tajwarTX/Team-X-FANATIC/t-photos/serious.jpg

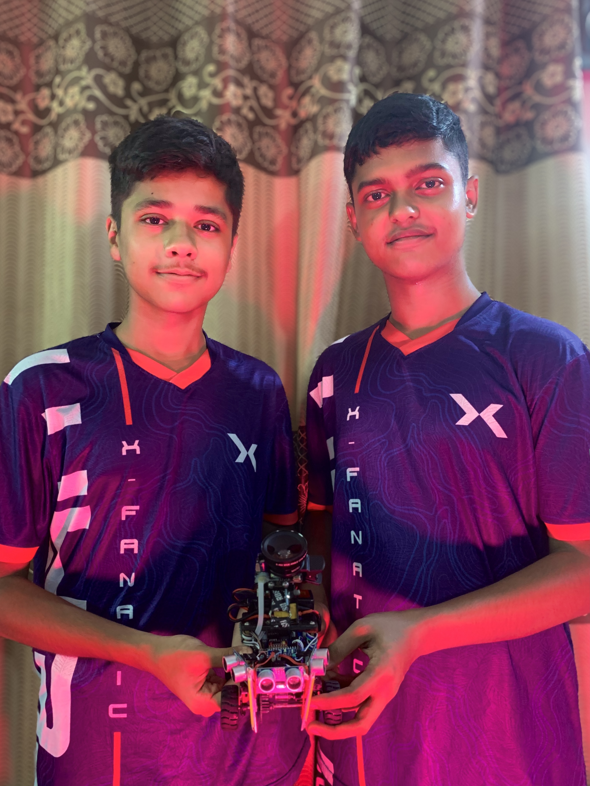
t-photos/serious.jpg
