tajwarTX/Team-X-FANATIC/v-photos/bottom.JPG

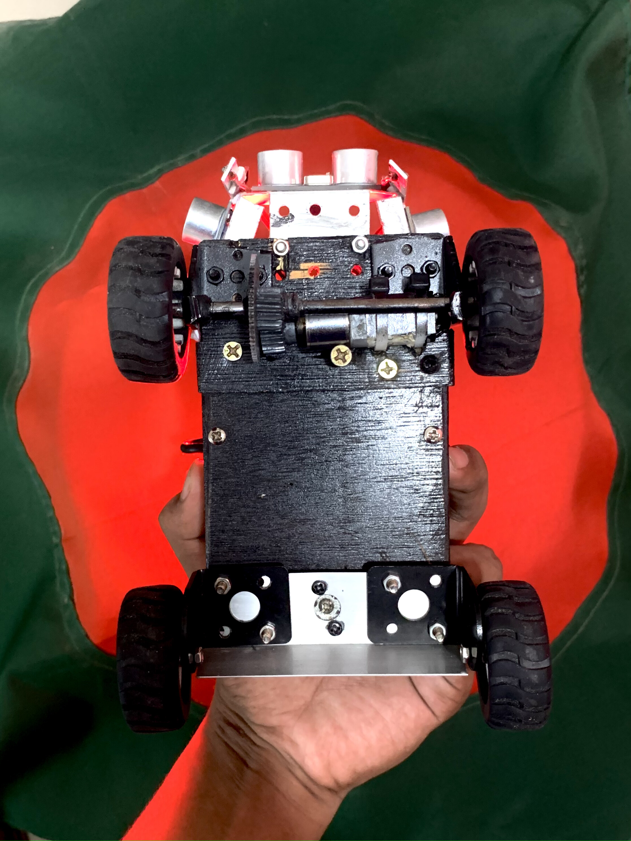
v-photos/bottom.JPG
