tajwarTX/Team-X-FANATIC/other/README.md

# Robot Setup

- We install the latest Arduino IDE on our computer from: arduino.cc/en/Main/Software.
<br/>

NAUT

<br/>

- After we open the code, in the Arduino IDE, go to Tools > Board > Arduino AVR Boards, and then select the Arduino Nano as we are using Nano as the main microcontroller for all the operation.

<br/>

NAUT

<br/>

- Again Open the Arduino Tools section : Tools > Processor > and select ATmega328P (Old Bootloader)

<br/>

NAUT

<br/>

- Change the COM port where the Arduino is connected through cables with the device.
<br/>

NAUT

<br/>

- Within the Arduino IDE, click the Upload button. Allow the code to compile and upload to the board for a short while. If the upload is successful, "Done Uploading" should appear.

<br/>

NAUT

<br/>
- If not, the error message can be like this. Just follow the previous steps again and change the COM port, and the code will be uploaded in no time.

NAUT

<br/>

- Place the robot on the track at this point, turn it on, and wait for the front servo to centre.

<br/>

- Once you press the button, it will begin to complete the laps.
