tajwarTX/Team-X-FANATIC/schemes/Circuit 0.1.2.pdf

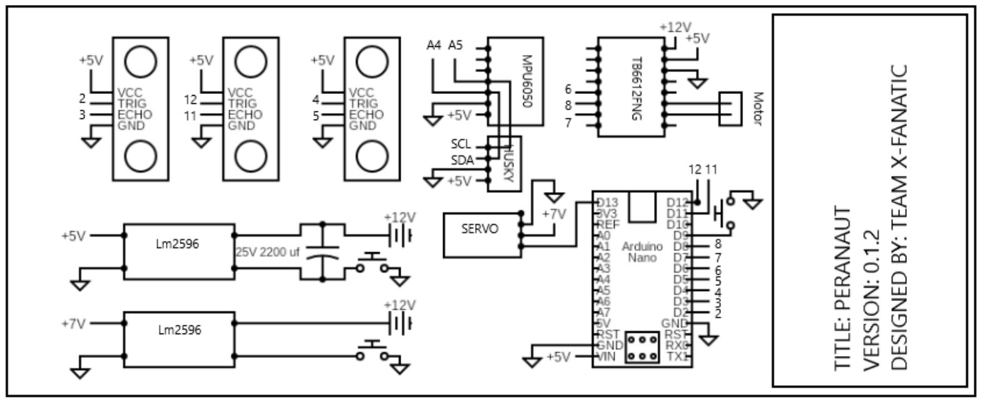
[picture p3: page 1]
