tajwarTX/Team-X-FANATIC/models/V_0.0.1.JPG

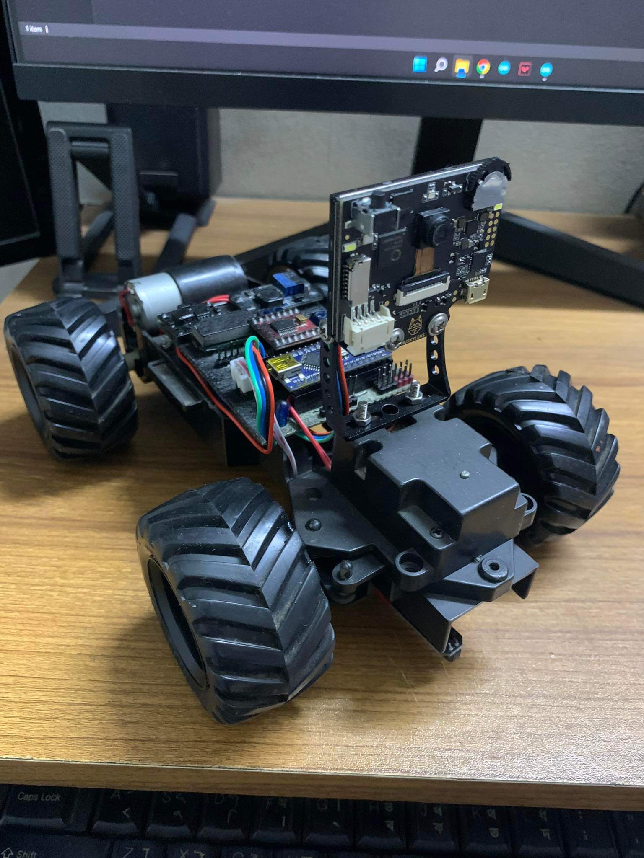
models/V_0.0.1.JPG
