tajwarTX/Team-X-FANATIC/models/V_0.0.2.JPG

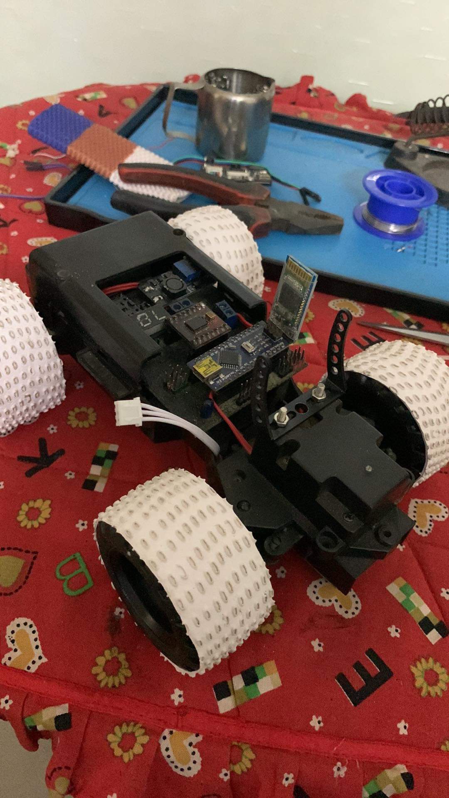
models/V_0.0.2.JPG
