tajwarTX/Team-X-FANATIC/models/V_0.0.3.JPG

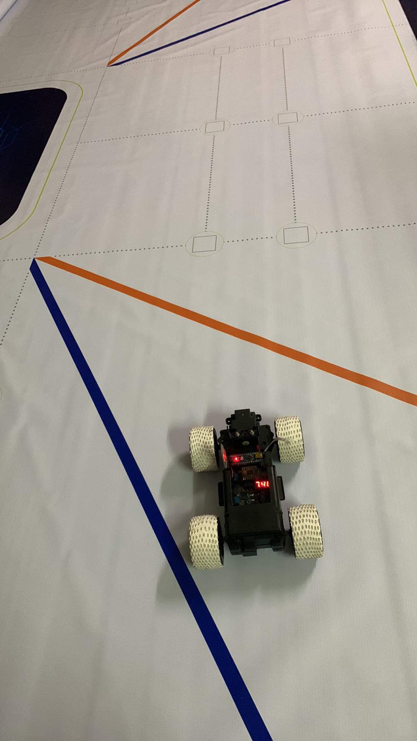
models/V_0.0.3.JPG
