tajwarTX/Team-X-FANATIC/models/V_0.0.4.jpg

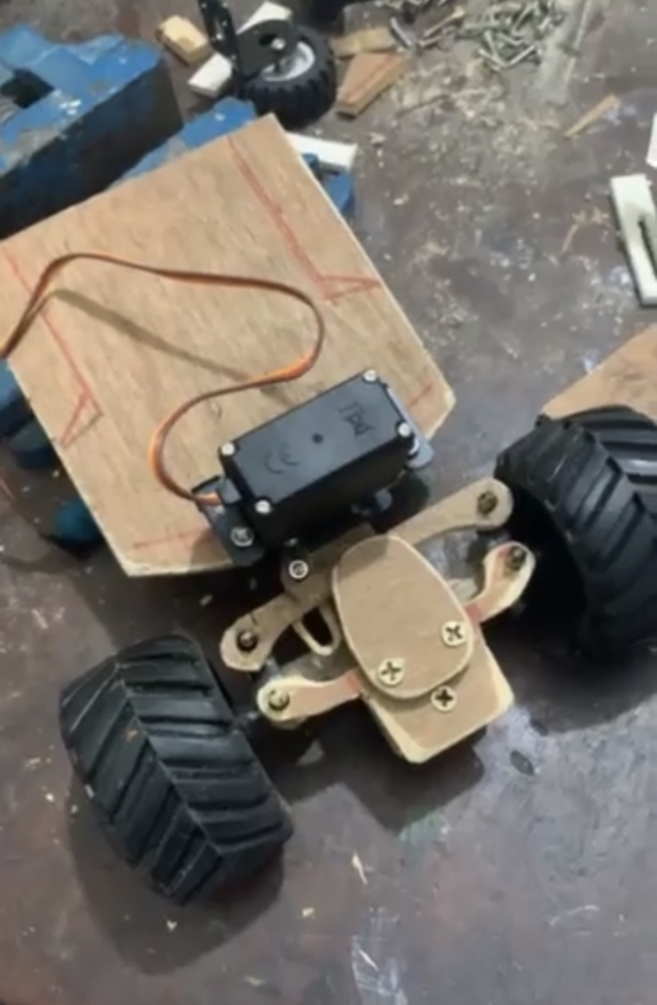
models/V_0.0.4.jpg
