tajwarTX/Team-X-FANATIC/models/V_0.1.0.JPG

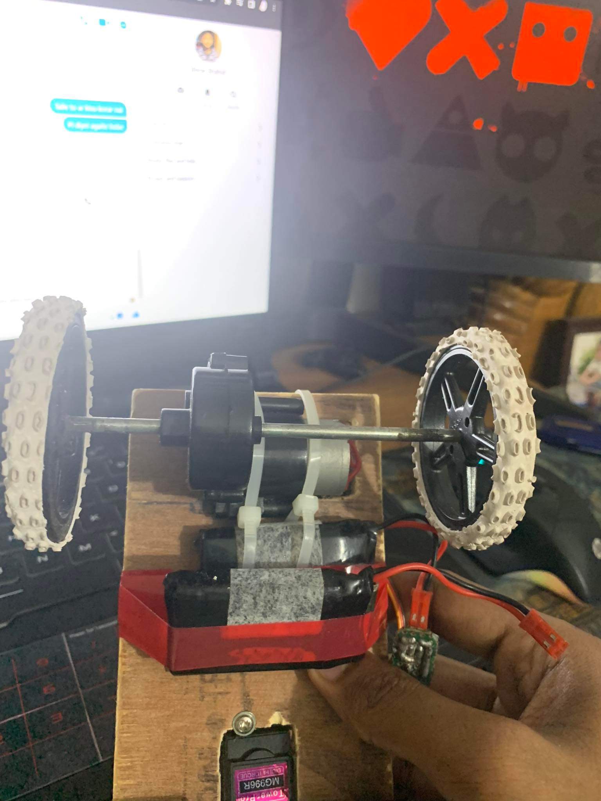
models/V_0.1.0.JPG
