tajwarTX/Team-X-FANATIC/schemes/Circuit 0.1.2.jpg

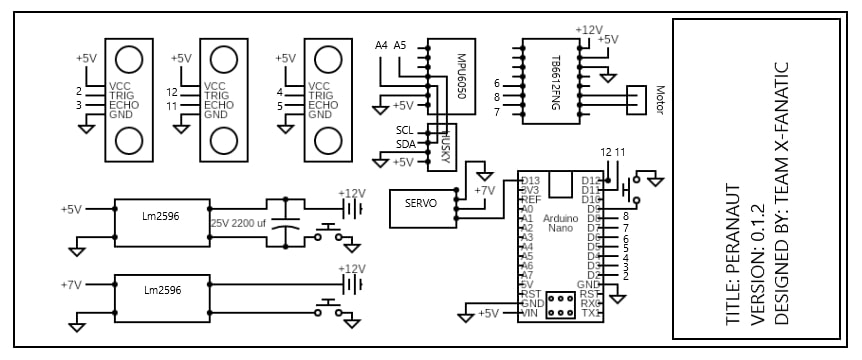
schemes/Circuit 0.1.2.jpg
