tajwarTX/Team-X-FANATIC/t-photos/funny.jpg

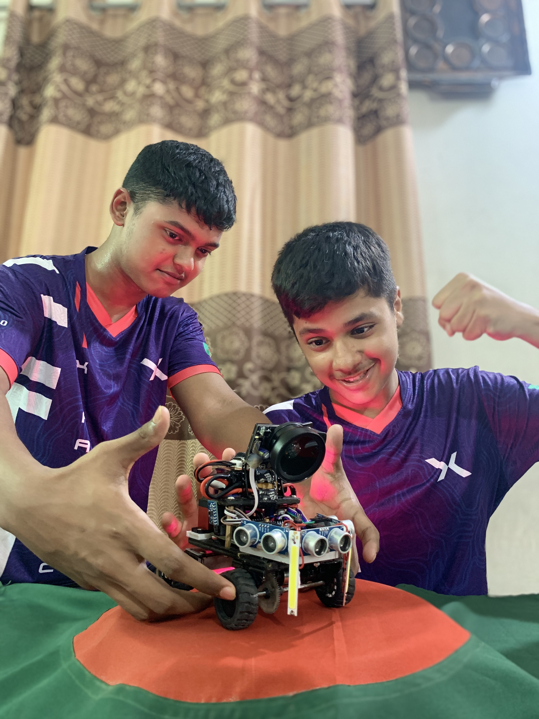
t-photos/funny.jpg
