tajwarTX/Team-X-FANATIC/v-photos/back.JPG

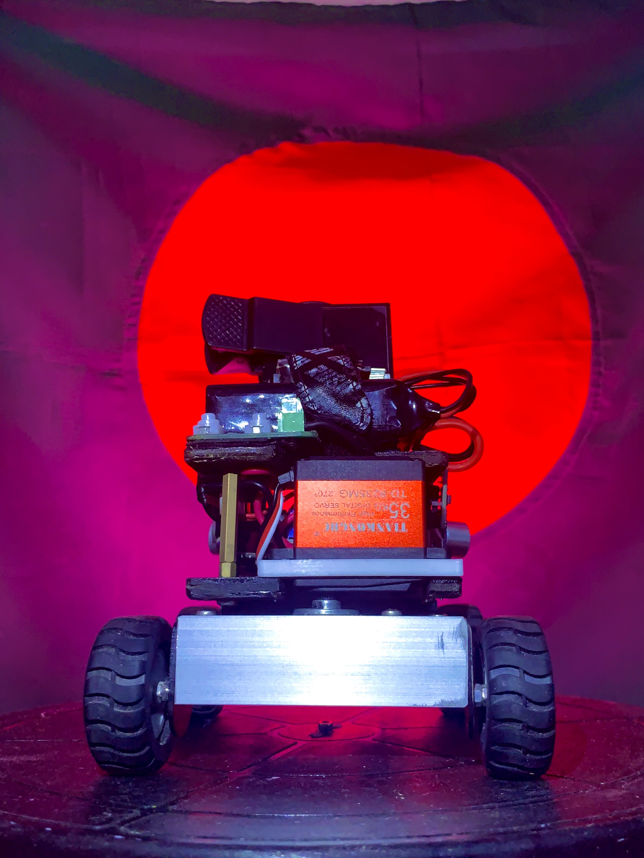
v-photos/back.JPG
