tajwarTX/Team-X-FANATIC/v-photos/front.jpg

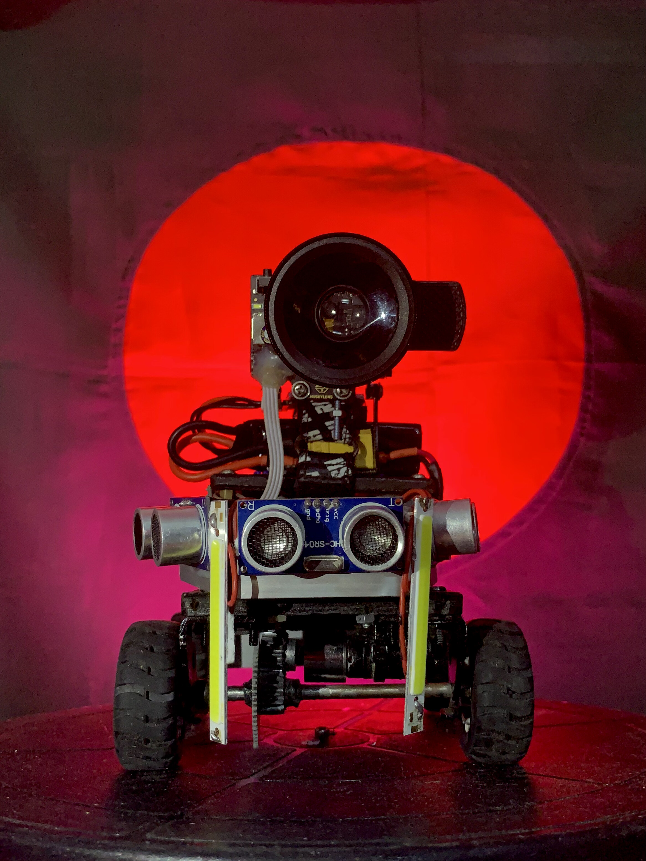
v-photos/front.jpg
