tajwarTX/Team-X-FANATIC/v-photos/left.JPG

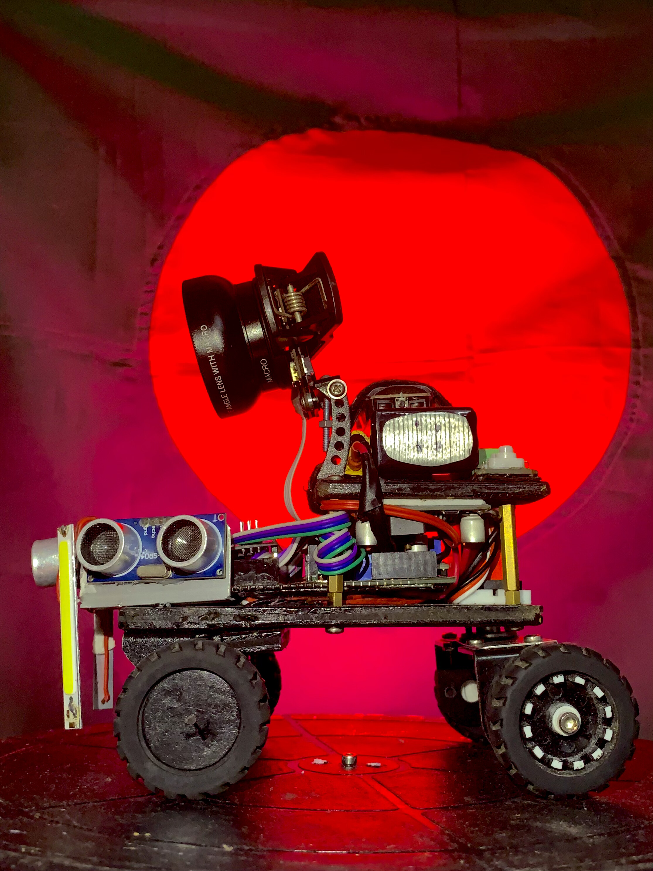
v-photos/left.JPG
