tajwarTX/Team-X-FANATIC/v-photos/right.JPG

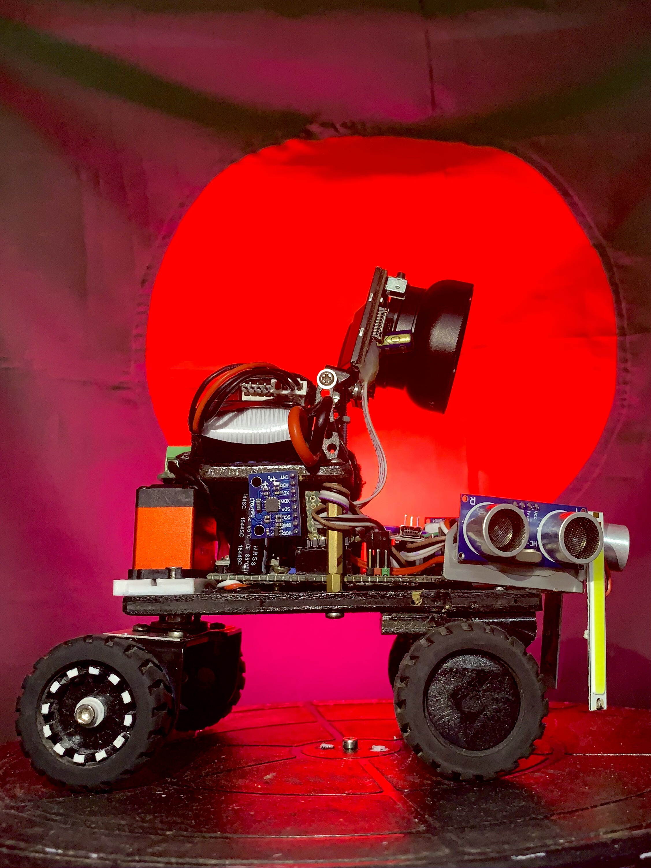
v-photos/right.JPG
