tajwarTX/Team-X-FANATIC/v-photos/top.JPG

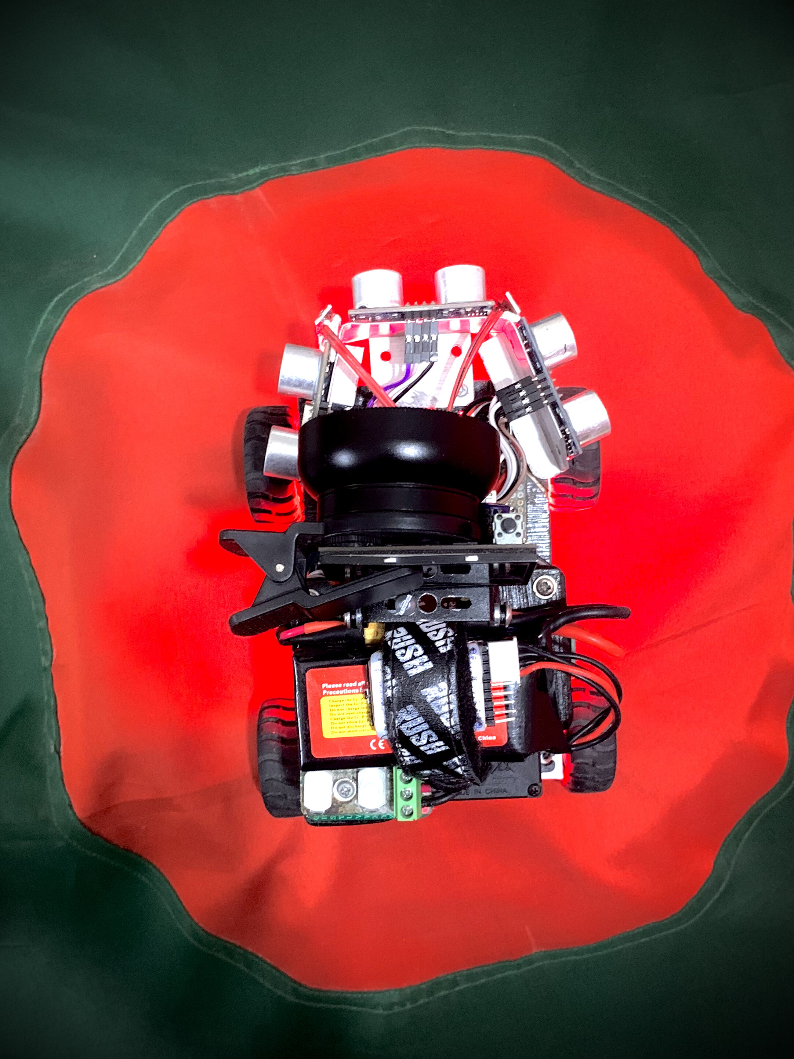
v-photos/top.JPG
