tajwarTX/Team-X-FANATIC/src/open/clockwise.ino

void clockwise(int disfr, int disrt, int dislt,  float *currentAngle, int *flagCalibrate) {
  *flagCalibrate = 0;
  motor(165);
  if (disfr < 80 && disfr != 0) {
    motor(120);
  }
  if ((disfr < 90 && disfr != 0) && (disrt > 70 || disrt == 0)) {
    *flagCalibrate = 1;
    count[0] = count[0] + 1;
    if ( count [0] != 12) {
      axis.write(80);
      motor(120);
      *currentAngle = 0.0;
      delay(450);
      axis.write(m);
      motor(165);
      delay(500);
    }
    else {
      axis.write(80);
      motor(120);
      delay(460);
      axis.write(m);
      motor(165);
      delay(750);
      stp();
      exit(0);
    }
  }
  else {
    int error = (dislt - disrt);
    if (abs(error) < 90) {
      axis.write(constrain(map(error, -80, 80, 90, 115), 90, 115));
    }
    else {
      if (disrt < dislt) {
        axis.write(120);
      }
      else if (dislt < disrt) {
        axis.write(85);
      }
      else {
        motor(0);
      }
    }
  }



}
